sanjay-kalagarla/Hand-Gesture-Controlled-Rover/images/internal structure 2.jpeg

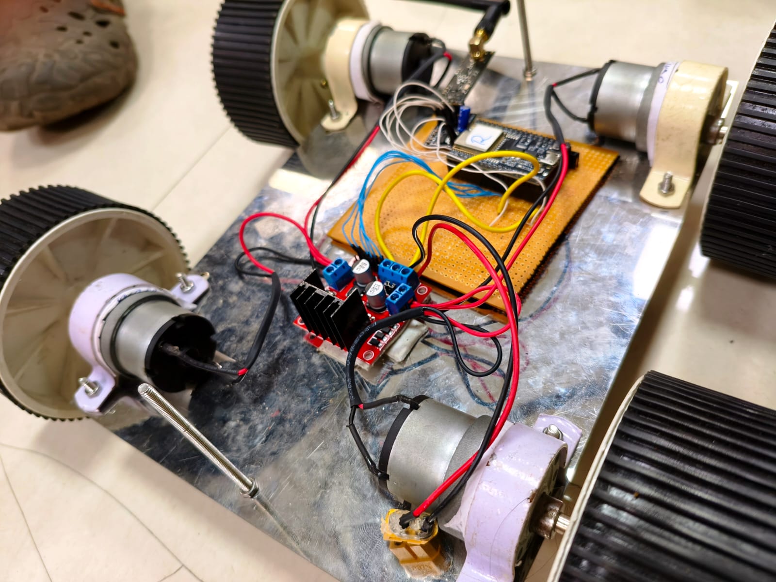
images/internal structure 2.jpeg
