sanjay-kalagarla/Hand-Gesture-Controlled-Rover/images/internal structure 1.jpeg

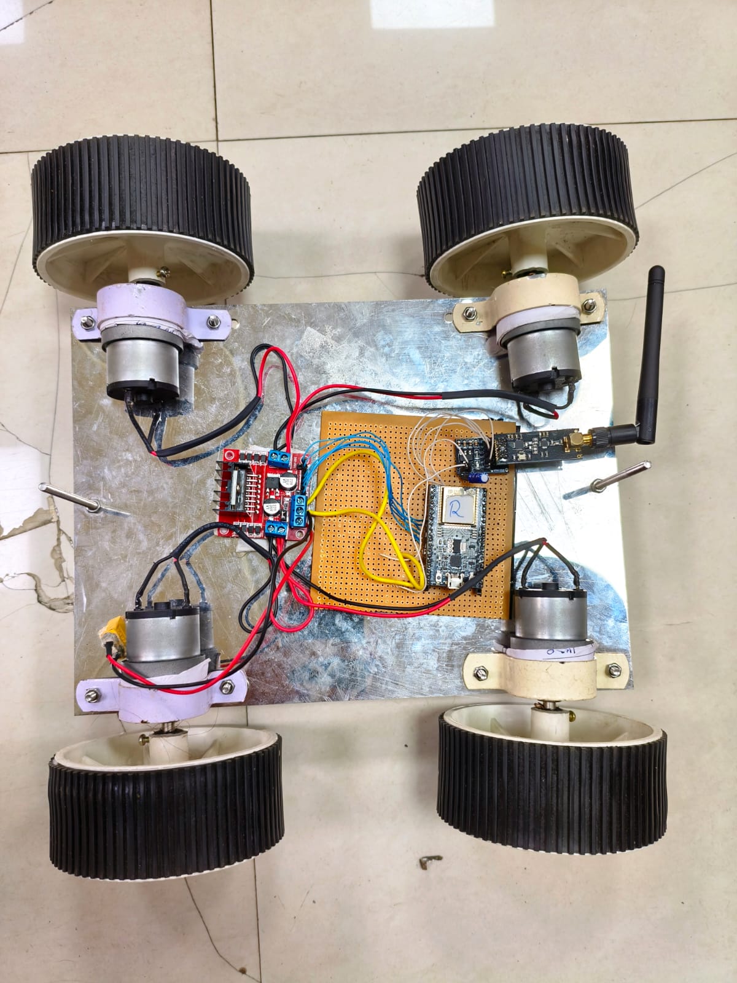
images/internal structure 1.jpeg
