sanjay-kalagarla/Hand-Gesture-Controlled-Rover/images/external structure with the transmitter.jpeg

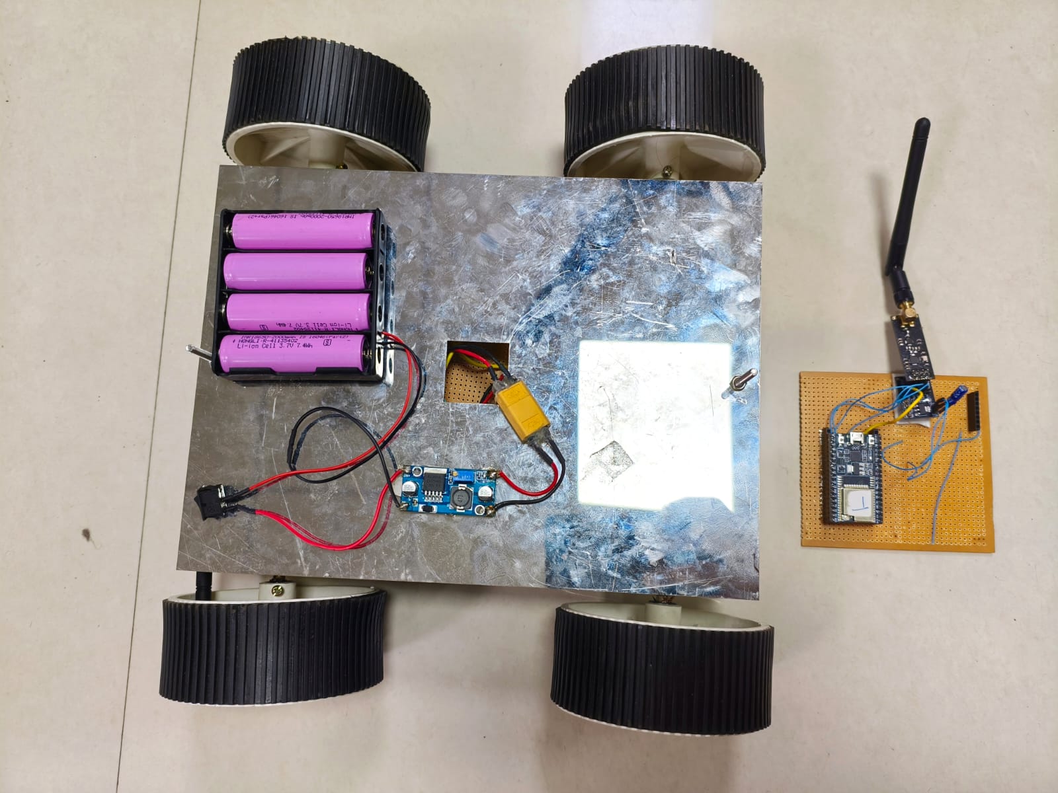
images/external structure with the transmitter.jpeg
